bapsespace/MMR_RideHeightSensor/README.md

# MMR_RideHeightSensor
- [ ] **SALADARE seconda scheda**
- [ ] **CONTROLLARE SCHEMATICO CIRCUITO ride height sensor, (NON può funzionare ?)**
- [ ] **CALIBRARE SENSORI ALTEZZA E TEMPERATURE, nelle look up table**
## Note sul PCB
- [ ] Testare Laser sensor (check voltage divider / current mesuring circuit )
- [x] PT6 NON COLLEGATO, errore design PCB, (_non è indispinsabile basta ricordarsi di non usarlo_)
- [x] Da risaldare OPAMP e i 2 FUsibili per laser distance sensors
- [x] In fase di TEST ricordarsi di attaccare resistenza 120Ohm sul CANBUS

## Note sul Codice
- [ ] Forse si può ottimizzare ancora il codice Analog_Read_ALL(), Settare prima il mux e poi adc sweep, ma è da verificare se effettivamente è più voloce o no 
- [x] CAN, test message funziona, implementare invio dati ADC
- [x] aggiungere funzione conversione, adc_raw -> adce_voltage  (-32k : +32K [signed int 16bit]  -> -2.048V : +2.048V [float])
- [x] Ride Height, Aggiungere funzione calibrazione specifica **solo** per Sensori Laser Distanza
- [x] PT, aggiungere funzione calibrazione specifica di conversione **solo** per PT pin

## Note Varie

- [x] L'ADC funziona con il codice: "RideHeighSensorV3_ADC_OK"

- [x] Quando l'adc funziona in I2C, porgrammare Multiplexers TMUX1309
    - *Unused logic control pins must be tied to GND or VDD to ensure the device does not consume additional current as highlighted in Implications of Slow or Floating OS Inputs. Unused signal path inputs (Sx and Dx) should be connected to GND.*
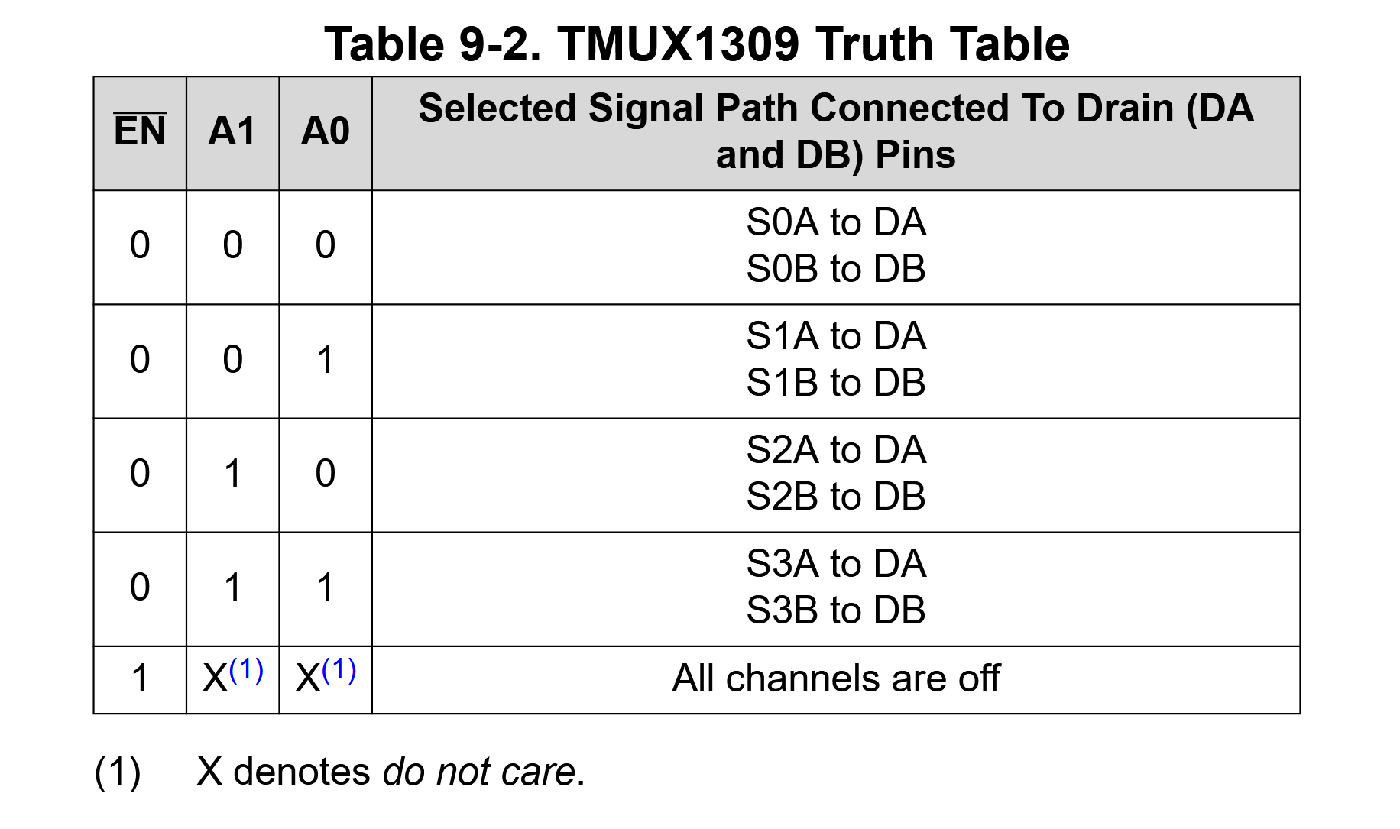
[picture p1: MUX Control Table.png]
Table
    

```
    MUX1				PB4	PB5
	(DA --> AIN0)			A1	A0
		[S0A --> ADC1]		0	0	ok	FUNZIONA
		[S1A --> ]		0	1	ok	-
		[S2A --> PT1]		1	0	ok	FUNZIONA
		[S3A --> ADC2]		1	1	ok	FUNZIONA

	(DB --> AIN1)	
		[S0B --> PT2]		0	0	ok	FUNZIONA
		[S1B --> PT8]		0	1	ok	FUNZIONA
		[S2B --> PT4]		1	0	ok	FUNZIONA
		[S3B --> PT6]		1	1	ok	- ERRORE NEL PCB, NON COLLEGATO 

    MUX2				PB10	PB11
	(DA --> AIN2)			A1	A0
		[S0A --> PT3]		0	0	ok	FUNZIONA
		[S1A --> PT5]		0	1	ok	FUNZIONA
		[S2A --> PT7]		1	0	ok	FUNZIONA
		[S3A --> Height_Right]	1	1	ok	FUNZIONA

	(DB --> AIN3)			
		[S0B --> ]		0	0	ok	-
		[S1B --> Height_Left]	0	1	ok	FUNZIONA
		[S2B --> ]		1	0	ok	-
		[S3B --> ]		1	1	ok	-
```

- [x] Quando i multiplexer funzionano, programmare CAN MCP2562-E/SN
    - CAN RX TX, PA11, PA12
    - Solito modulo CAN riciclare codice da optocouple board

- [x] Quando tutti i sensori funzionano si può collegare i sensori di distanza , e cominciare a definire la funzione di calibrazione della misura
    - Arduino MAP function

- [x] High level coding, main Code 
    - Loop tra i vari canali dei MUX Salva dato e manda in can
