bapsespace/MMR_RideHeightSensor/Note.txt

PA15 --> 32  Pin reset I2C 

2 Multiplexer che mandano all'ADC

TMUX1309
