bapsespace/MMR_RideHeightSensor/CAN analyzer pinout.png

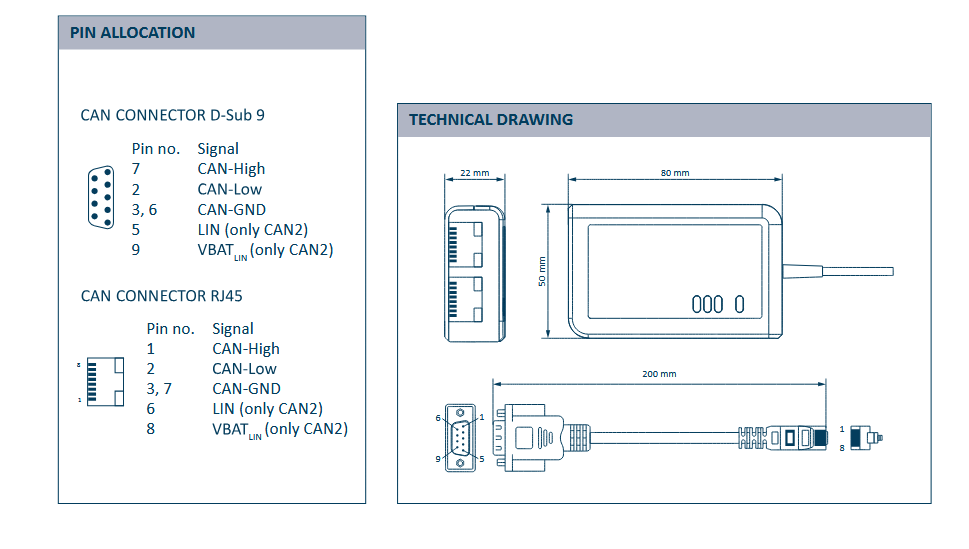
CAN analyzer pinout.png
