bapsespace/MMR_RideHeightSensor/CAN Pinout.png

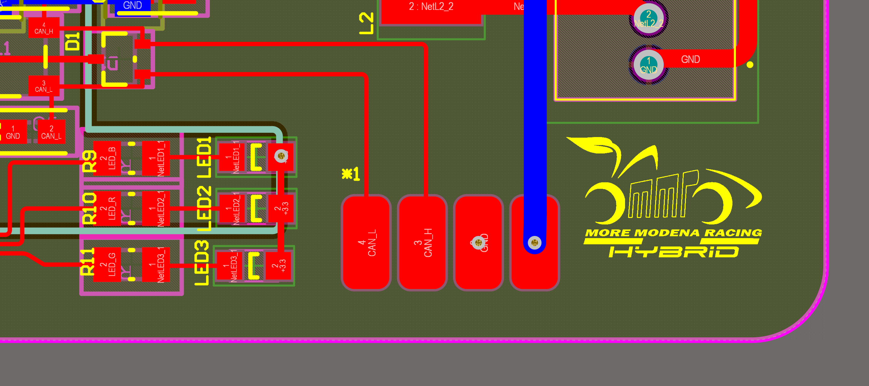
CAN Pinout.png
