bapsespace/MMR_RideHeightSensor/programming PINOUT.png

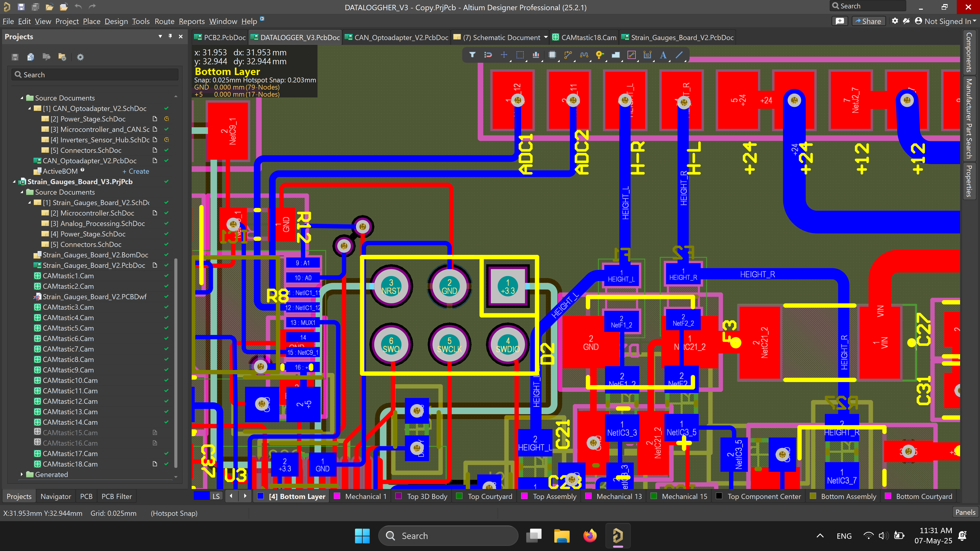
programming PINOUT.png
