bapsespace/MMR_RideHeightSensor/STl-link PINOUT.png

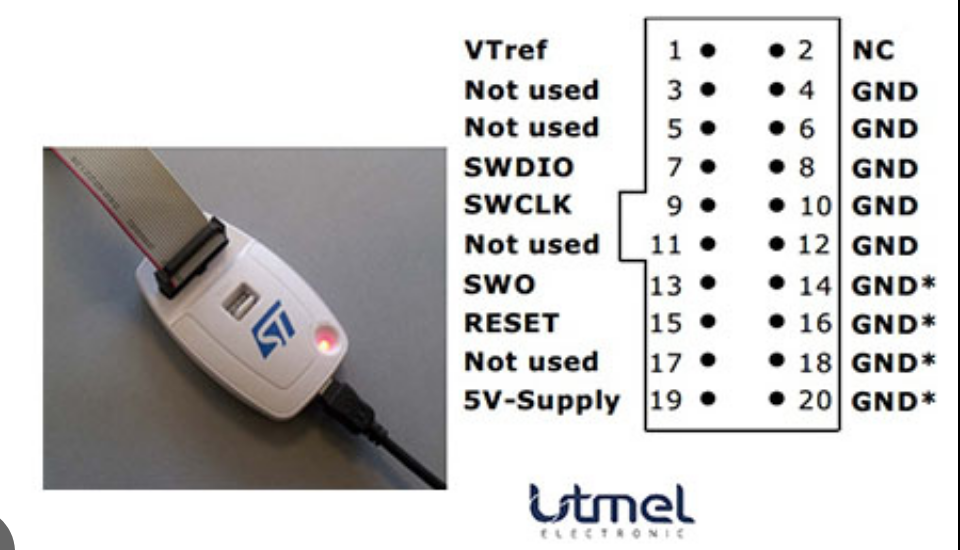
STl-link PINOUT.png
