bapsespace/MMR_RideHeightSensor/src/RideHeightSensorV4_ADC_OK_MUX_OK_CAN_OK/RideHeightSensor/Core/Src/main.c

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
/* Includes ------------------------------------------------------------------*/
#include "main.h"

/* USER CODE BEGIN Includes */
#include "core_cm3.h"  // for __NOP
#include "stm32f1xx_hal.h"
/* USER CODE END Includes */

/* USER CODE BEGIN PD */
//ADC
#define ADS1119_ADDR     (0x40 << 1)  // 7-bit address + R/W bit
#define ADS1119_REG_CONFIG   0x40
#define ADS1119_CMD_START    0x08
#define ADS1119_CMD_READ     0x10
#define ADS1119_CMD_RESET    0x06

//Testato funziona NON MODIFICARE
#define CONFIG_AIN0   0b01101111 // AIN0 - AGND
#define CONFIG_AIN1   0b10001111 //	AIN1 - AGND
#define CONFIG_AIN2   0b10101111 //	AIN2 - AGND
#define CONFIG_AIN3   0b11001111 // AIN3 - AGND


#define MUX1_A0_B GPIO_PIN_5
#define MUX1_A1_B GPIO_PIN_4

#define MUX2_A0_B GPIO_PIN_11
#define MUX2_A1_B GPIO_PIN_10



#define CAN_ID_MAIN_DATA 0x318 // ID messaggio ride height (2byte l'uno): left + rigt + adc1 + adc2


/* USER CODE END PD */

CAN_HandleTypeDef hcan;

I2C_HandleTypeDef hi2c1;

TIM_HandleTypeDef htim1;

/* USER CODE BEGIN PV */

// Global variables for timing flags
volatile uint8_t flag_1ms = 0;
volatile uint8_t flag_10ms = 0;
volatile uint8_t flag_100ms = 0;
volatile uint8_t flag_1000ms = 0;

// Counter variables
volatile uint16_t ms_counter = 0;

// Globals for debug timing
volatile uint32_t exec_time_1ms = 0; // should not exceed 50_000
volatile uint32_t exec_time_10ms = 0; // should not exceed 500_000
volatile uint32_t exec_time_100ms = 0; // should not exceed 5_000_000
volatile uint32_t exec_time_1000ms = 0; // should not exceed 50_000_000

// Helper macro to compute time difference with wraparound
#define SYSTICK_DIFF(start, end) ((start >= end) ? (start - end) : (SysTick->LOAD - end + start))





// CAN
CAN_TxHeaderTypeDef can_main_data_TxHeader;
uint32_t can_TxMailbox = 0;
uint8_t can_main_data[8] = {0x00};


// ADC
int16_t pt_analog_in_raw[8] = {0};
int16_t adc_analog_in_raw[2] = {0};
int16_t height_right_analog_in_raw = 0;
int16_t height_left_analog_in_raw = 0;

// Converted millivolt values
int32_t pt_analog_in_mv[8] = {0};
int32_t adc_analog_in_mv[2] = {0};
int32_t height_right_analog_in_mv = 0;
int32_t height_left_analog_in_mv = 0;

// Calibrated distance outputs (in mm)
float distance_right_mm = 0.0f;
float distance_left_mm = 0.0f;

float pt_analog_in_temp[8] = {0.0f};



// CONFIG byte for differential AIN0-AIN1, Gain = 1, 20 SPS, continuous mode
uint8_t config_data[2] = {0x01, 0b00000100};  // Register address + config byte



//LOOKUP TABLES
// Structure for a lookup table
typedef struct {
    const int32_t *input_values;  // Array of input values (mV)
    const float *output_values;   // Array of output values (mm or °C)
    uint8_t size;                 // Number of entries in the table
} LookupTable_t;



// Table for height sensor RIGHT
// Current Sensor Baseline {870, 2051, 3210, 4335};
// Voltage Sensor Baseline PROBLEMA voltage creep
static const int32_t height_right_input_mv[] = {870, 2051, 3210, 4335};
static const float height_right_output_mm[] = {16.0f, 51.0f, 86.0f, 120.0f};
LookupTable_t height_right_table = {
    .input_values = height_right_input_mv,
    .output_values = height_right_output_mm,
    .size = 4
};

// Table for height sensor LEFT
// Current Sensor Baseline {866, 2045, 3200, 4328};
// Voltage Sensor Baseline PROBLEMA voltage creep
static const int32_t height_left_input_mv[] = {866, 2045, 3200, 4328};
static const float height_left_output_mm[] = {16.0f, 51.0f, 86.0f, 120.0f};
LookupTable_t height_left_table = {
    .input_values = height_left_input_mv,
    .output_values = height_left_output_mm,
    .size = 4
};


// Table for temperature sensor
static const int32_t temp_input_mv[] = {0, 1000, 2000, 3000};
static const float temp_output_c[] = {-10.0f, 25.0f, 60.0f, 100.0f};
LookupTable_t temp_table = {
    .input_values = temp_input_mv,
    .output_values = temp_output_c,
    .size = 4
};


/* USER CODE END PV */

void SystemClock_Config(void);
static void MX_GPIO_Init(void);
static void MX_I2C1_Init(void);
static void MX_CAN_Init(void);
static void MX_TIM1_Init(void);
/* USER CODE BEGIN PFP */
void ADS1119_Reset(I2C_HandleTypeDef *hi2c);
void ADS1119_Start(I2C_HandleTypeDef *hi2c);
void ADS1119_Config(I2C_HandleTypeDef *hi2c, int port_number);
int16_t ADS1119_Read(I2C_HandleTypeDef *hi2c);
int32_t ADS1119_ConvertToMillivolts(int16_t raw_value);

void SetMUX(uint8_t mux_value);

void ConvertMilliVoltsToDistance(void);
void ConvertMilliVoltsToTemperature(void);

void ConvertAllAdcToMillivolts(void);

void Analog_Read_ALL(void);

float LookupWithInterpolation(const LookupTable_t *table, int32_t input);


void SystemClock_Config(void);
static void MX_GPIO_Init(void);
static void MX_CAN_Init(void);

void CAN_Config(void);

void SendMainDataToCan(void);

/* USER CODE END PFP */

/**
  * @brief  The application entry point.
  * @retval int
  */
int main(void)
{

  /* MCU Configuration--------------------------------------------------------*/

  /* Reset of all peripherals, Initializes the Flash interface and the Systick. */
  HAL_Init();

  /* Configure the system clock */
  SystemClock_Config();

  /* Initialize all configured peripherals */
  MX_GPIO_Init();
  MX_I2C1_Init();
  MX_CAN_Init();
  MX_TIM1_Init();
  /* Infinite loop */
  /* USER CODE BEGIN WHILE */

  ADS1119_Reset(&hi2c1);
  ADS1119_Start(&hi2c1);

  HAL_Delay(10);

  //HAL_CAN_Stop(&hcan);
  HAL_CAN_Start(&hcan);

  // Start TIM1 in interrupt mode
  HAL_TIM_Base_Start_IT(&htim1);


  while (1) {
      uint32_t start, end;

      if (flag_1ms) {
          flag_1ms = 0;
          start = SysTick->VAL;

          // 1ms tasks here

          end = SysTick->VAL;
          exec_time_1ms = SYSTICK_DIFF(start, end);
      }

      if (flag_10ms) {
          flag_10ms = 0;
          start = SysTick->VAL;

          // 10ms tasks
          Analog_Read_ALL();
          ConvertAllAdcToMillivolts();
          ConvertMilliVoltsToDistance();
          ConvertMilliVoltsToTemperature();
          SendMainDataToCan();

          end = SysTick->VAL;
          exec_time_10ms = SYSTICK_DIFF(start, end);
      }

      if (flag_100ms) {
          flag_100ms = 0;
          start = SysTick->VAL;

          // 100ms tasks

          end = SysTick->VAL;
          exec_time_100ms = SYSTICK_DIFF(start, end);
      }

      if (flag_1000ms) {
          flag_1000ms = 0;
          start = SysTick->VAL;

          // 1 second tasks

          end = SysTick->VAL;
          exec_time_1000ms = SYSTICK_DIFF(start, end);
      }
  }


    /* USER CODE END WHILE */

}

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
/* USER CODE BEGIN 4 */

void ADS1119_Reset(I2C_HandleTypeDef *hi2c){
    uint8_t reset_cmd = ADS1119_CMD_RESET;
    HAL_I2C_Master_Transmit(hi2c, ADS1119_ADDR, &reset_cmd, 1, HAL_MAX_DELAY);

    HAL_Delay(5);  // Allow reset time
}


void ADS1119_Start(I2C_HandleTypeDef *hi2c){
    // 3. Start conversion
    uint8_t start_cmd = ADS1119_CMD_START;
    HAL_I2C_Master_Transmit(hi2c, ADS1119_ADDR, &start_cmd, 1, HAL_MAX_DELAY);
}

void ADS1119_Config(I2C_HandleTypeDef *hi2c, int port_number){

	   // 2. Configure for AIN0-AIN1, gain = 1, 20SPS, continuous, internal ref
	    uint8_t config_data[2] ;
	    config_data[0] = ADS1119_REG_CONFIG;

	    if (port_number==0)
	    	config_data[1] = CONFIG_AIN0;
	    if (port_number==1)
			config_data[1] = CONFIG_AIN1;
	    if (port_number==2)
			config_data[1] = CONFIG_AIN2;
	    if (port_number==3)
			config_data[1] = CONFIG_AIN3;

	    HAL_I2C_Master_Transmit(hi2c, ADS1119_ADDR, config_data, 2, HAL_MAX_DELAY);

}

int16_t ADS1119_Read(I2C_HandleTypeDef *hi2c) {
    HAL_StatusTypeDef ret;
    uint8_t data[2];

    // 5. Read conversion result
    uint8_t read_cmd = ADS1119_CMD_READ;
    ret = HAL_I2C_Master_Transmit(hi2c, ADS1119_ADDR, &read_cmd, 1, HAL_MAX_DELAY);
    if (ret != HAL_OK) return -10003;

    ret = HAL_I2C_Master_Receive(hi2c, ADS1119_ADDR, data, 2, HAL_MAX_DELAY);
    if (ret != HAL_OK) return -10004;

    int16_t adc_result = (data[0] << 8) | data[1];
    return adc_result;
}

void Analog_Read_ALL(void){


	ADS1119_Config(&hi2c1,0);
	ADS1119_Start(&hi2c1);

	SetMUX(0b00000000);
    adc_analog_in_raw[0] = ADS1119_Read(&hi2c1); 	//ADC1

    SetMUX(0b00000101);
    // NC

    SetMUX(0b00001010);
    pt_analog_in_raw[0] = ADS1119_Read(&hi2c1); 	//PT1

    SetMUX(0b00001111);
    adc_analog_in_raw[1] = ADS1119_Read(&hi2c1); 	//ADC2



	ADS1119_Config(&hi2c1,1);
	ADS1119_Start(&hi2c1);

	SetMUX(0b00000000);
	pt_analog_in_raw[1] = ADS1119_Read(&hi2c1);	//PT2

    SetMUX(0b00000101);
    pt_analog_in_raw[7] = ADS1119_Read(&hi2c1);	//PT8

    SetMUX(0b00001010);
    pt_analog_in_raw[3] = ADS1119_Read(&hi2c1);	//PT4

    SetMUX(0b00001111);
    pt_analog_in_raw[5] = 0;//ADS1119_Read(&hi2c1,1);	//PT6 PCB ERROR NOT CONNECTED



	ADS1119_Config(&hi2c1,2);
	ADS1119_Start(&hi2c1);

	SetMUX(0b00000000);
	pt_analog_in_raw[2] = ADS1119_Read(&hi2c1);	//PT3

    SetMUX(0b00000101);
    pt_analog_in_raw[4] = ADS1119_Read(&hi2c1);	//PT5

    SetMUX(0b00001010);
    pt_analog_in_raw[6] = ADS1119_Read(&hi2c1);	//PT7

    SetMUX(0b00001111);
    height_left_analog_in_raw = ADS1119_Read(&hi2c1);//Height Left


	ADS1119_Config(&hi2c1,3);
	ADS1119_Start(&hi2c1);

	SetMUX(0b00000000);
	// NC

    SetMUX(0b00000101);
    height_right_analog_in_raw = ADS1119_Read(&hi2c1);//Height Right

    SetMUX(0b00001010);
    // NC

    SetMUX(0b00001111);
    // NC

}

void SetMUX(uint8_t mux_value) {
    // Extract each bit from the mux_value
    uint8_t mux1_a0 = (mux_value >> 0) & 0x01;
    uint8_t mux1_a1 = (mux_value >> 1) & 0x01;
    uint8_t mux2_a0 = (mux_value >> 2) & 0x01;
    uint8_t mux2_a1 = (mux_value >> 3) & 0x01;

    // Set the GPIOs accordingly
    HAL_GPIO_WritePin(GPIOB, MUX1_A0_B, mux1_a0 ? GPIO_PIN_SET : GPIO_PIN_RESET);
    HAL_GPIO_WritePin(GPIOB, MUX1_A1_B, mux1_a1 ? GPIO_PIN_SET : GPIO_PIN_RESET);
    HAL_GPIO_WritePin(GPIOB, MUX2_A0_B, mux2_a0 ? GPIO_PIN_SET : GPIO_PIN_RESET);
    HAL_GPIO_WritePin(GPIOB, MUX2_A1_B, mux2_a1 ? GPIO_PIN_SET : GPIO_PIN_RESET);

    for(int i = 0; i<10000; i++){ // at least 8000
    	//empty loop to allow time for MUX to set
    	__NOP();
    }

}

void ConvertAllAdcToMillivolts(void) {
    // Convert PT analog inputs (8 channels)
    for(int i = 0; i < 8; i++) {
        pt_analog_in_mv[i] = ADS1119_ConvertToMillivolts(pt_analog_in_raw[i]);
    }

    // Convert ADC analog inputs (2 channels)
    for(int i = 0; i < 2; i++) {
        adc_analog_in_mv[i] = ADS1119_ConvertToMillivolts(adc_analog_in_raw[i]);
    }

    // Convert height sensors
    height_right_analog_in_mv = ADS1119_ConvertToMillivolts(height_right_analog_in_raw);
    height_left_analog_in_mv = ADS1119_ConvertToMillivolts(height_left_analog_in_raw);
}


int32_t ADS1119_ConvertToMillivolts(int16_t raw_value) {

    return (int32_t)(raw_value * 5000) / 32768;

}

void ConvertMilliVoltsToDistance(void) {
    distance_right_mm = LookupWithInterpolation(&height_right_table, height_right_analog_in_mv);
    distance_left_mm = LookupWithInterpolation(&height_left_table, height_left_analog_in_mv);
}

void ConvertMilliVoltsToTemperature(void){
    for(int i = 0; i < 8; i++) {
        pt_analog_in_temp[i] = LookupWithInterpolation(&temp_table, pt_analog_in_mv[i]);
    }
}


float LookupWithInterpolation(const LookupTable_t *table, int32_t input) {
    // Check for input below table range
    if(input <= table->input_values[0]) {
        return table->output_values[0];
    }

    // Check for input above table range
    if(input >= table->input_values[table->size-1]) {
        return table->output_values[table->size-1];
    }

    // Find the interval where input lies
    uint8_t i;
    for(i = 0; i < table->size-1; i++) {
        if(input < table->input_values[i+1]) {
            break;
        }
    }

    // Linear interpolation
    float slope = (table->output_values[i+1] - table->output_values[i]) /
                  (float)(table->input_values[i+1] - table->input_values[i]);

    return table->output_values[i] + slope * (input - table->input_values[i]);
}

void SendMainDataToCan(void){

    // Initialize the header fields
	can_main_data_TxHeader.StdId = CAN_ID_MAIN_DATA;          // Standard ID
	can_main_data_TxHeader.ExtId = 0x00;           // Not using extended ID
	can_main_data_TxHeader.RTR = CAN_RTR_DATA;     // Data frame (not remote)
	can_main_data_TxHeader.IDE = CAN_ID_STD;       // Standard ID
	can_main_data_TxHeader.DLC = 8;                // Send 8 bytes
	can_main_data_TxHeader.TransmitGlobalTime = DISABLE;

	can_main_data[0] = (uint8_t) (((uint16_t) (distance_right_mm * 10)) >> 8); //lohigh
	can_main_data[1] = (uint8_t) (distance_right_mm * 10);

	//i primi due byte sono heightSensor2
	can_main_data[2] = (uint8_t) (((uint16_t) (distance_left_mm * 10)) >> 8); //loHigh
	can_main_data[3] = (uint8_t) (distance_left_mm * 10);

	//
	can_main_data[4] = (uint8_t) (((uint16_t) adc_analog_in_mv[0]) >> 8); //loHigh
	can_main_data[5] = (uint8_t) (adc_analog_in_mv[0]);


	can_main_data[6] = (uint8_t) (((uint16_t) adc_analog_in_mv[1]) >> 8); //loHigh
	can_main_data[7] = (uint8_t) adc_analog_in_mv[1];


	if(HAL_CAN_AddTxMessage(&hcan, &can_main_data_TxHeader, can_main_data, &can_TxMailbox)!= HAL_OK)
	{
	Error_Handler();
	}
}


// Timer interrupt callback
void HAL_TIM_PeriodElapsedCallback(TIM_HandleTypeDef *htim)
{
    if (htim == &htim1)  // Check if the interrupt came from TIM1
    {
        flag_1ms = 1;  // Set 1ms flag

        ms_counter++;

        // Every 10ms (when counter is multiple of 10)
        if (ms_counter % 10 == 0) {
            flag_10ms = 1;
        }

        // Every 100ms (when counter is multiple of 100)
        if (ms_counter % 100 == 0) {
            flag_100ms = 1;
        }

        // Every 1000ms (when counter is multiple of 1000)
        if (ms_counter % 1000 == 0) {
            flag_1000ms = 1;
            ms_counter = 0;  // Reset counter to avoid overflow
        }
    }
}



/* USER CODE END 4 */
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
