bapsespace/MMR_RideHeightSensor/(commit log)

2025-05-14 adc FUNZIONA
2025-05-15 MUX ADC integration
    NON FUNZIONA da rivedere
2025-05-16 MUX E ADC FUNZIONAAAAAAAAAAAAAAA
2025-05-20 Update notes mux adc wiring.txt
2025-05-23 Funzioni di conversione
    Aggiunte funzioni di conversione adc -> millivolt
    e millivolt -> distance
2025-05-23 Aggiunte LookUpTable di Conversione Temp e distance
2025-05-29 ADC optimization & CAN message
2025-05-30 Current sensor, WORKING, and calibrated
2025-06-18 update fail safe,
    [Datalogger_103C8T7_V2.cfg]
