bapsespace/MMR_RideHeightSensor/(notices)

Notices in the files:
src/Temperature_Board_V6_shared/Temperature_Board_V6/Core/Src/main.c:
Copyright (c) 2023 STMicroelectronics.
All rights reserved.
This software is licensed under terms that can be found in the LICENSE file
